dezash123/drone/README.md

# drone
My drone: coded in rust, frame designed in [onshape](https://cad.onshape.com/documents/91c1fbb6d04f2dc72182ab9c/w/1d5775c73044c5da3d093724/e/ebeab2adf1bd9151a745482d), and PCB designed in KiCAD.

much of this was learned through trial and error, and looking back, kinda embarrassing, but I'll keep this around since it did work
