dezash123/drone/pcb/Drone_PCB.kicad_pcb

## KiCad design pcb/Drone_PCB.kicad_pcb (2023-07-20)

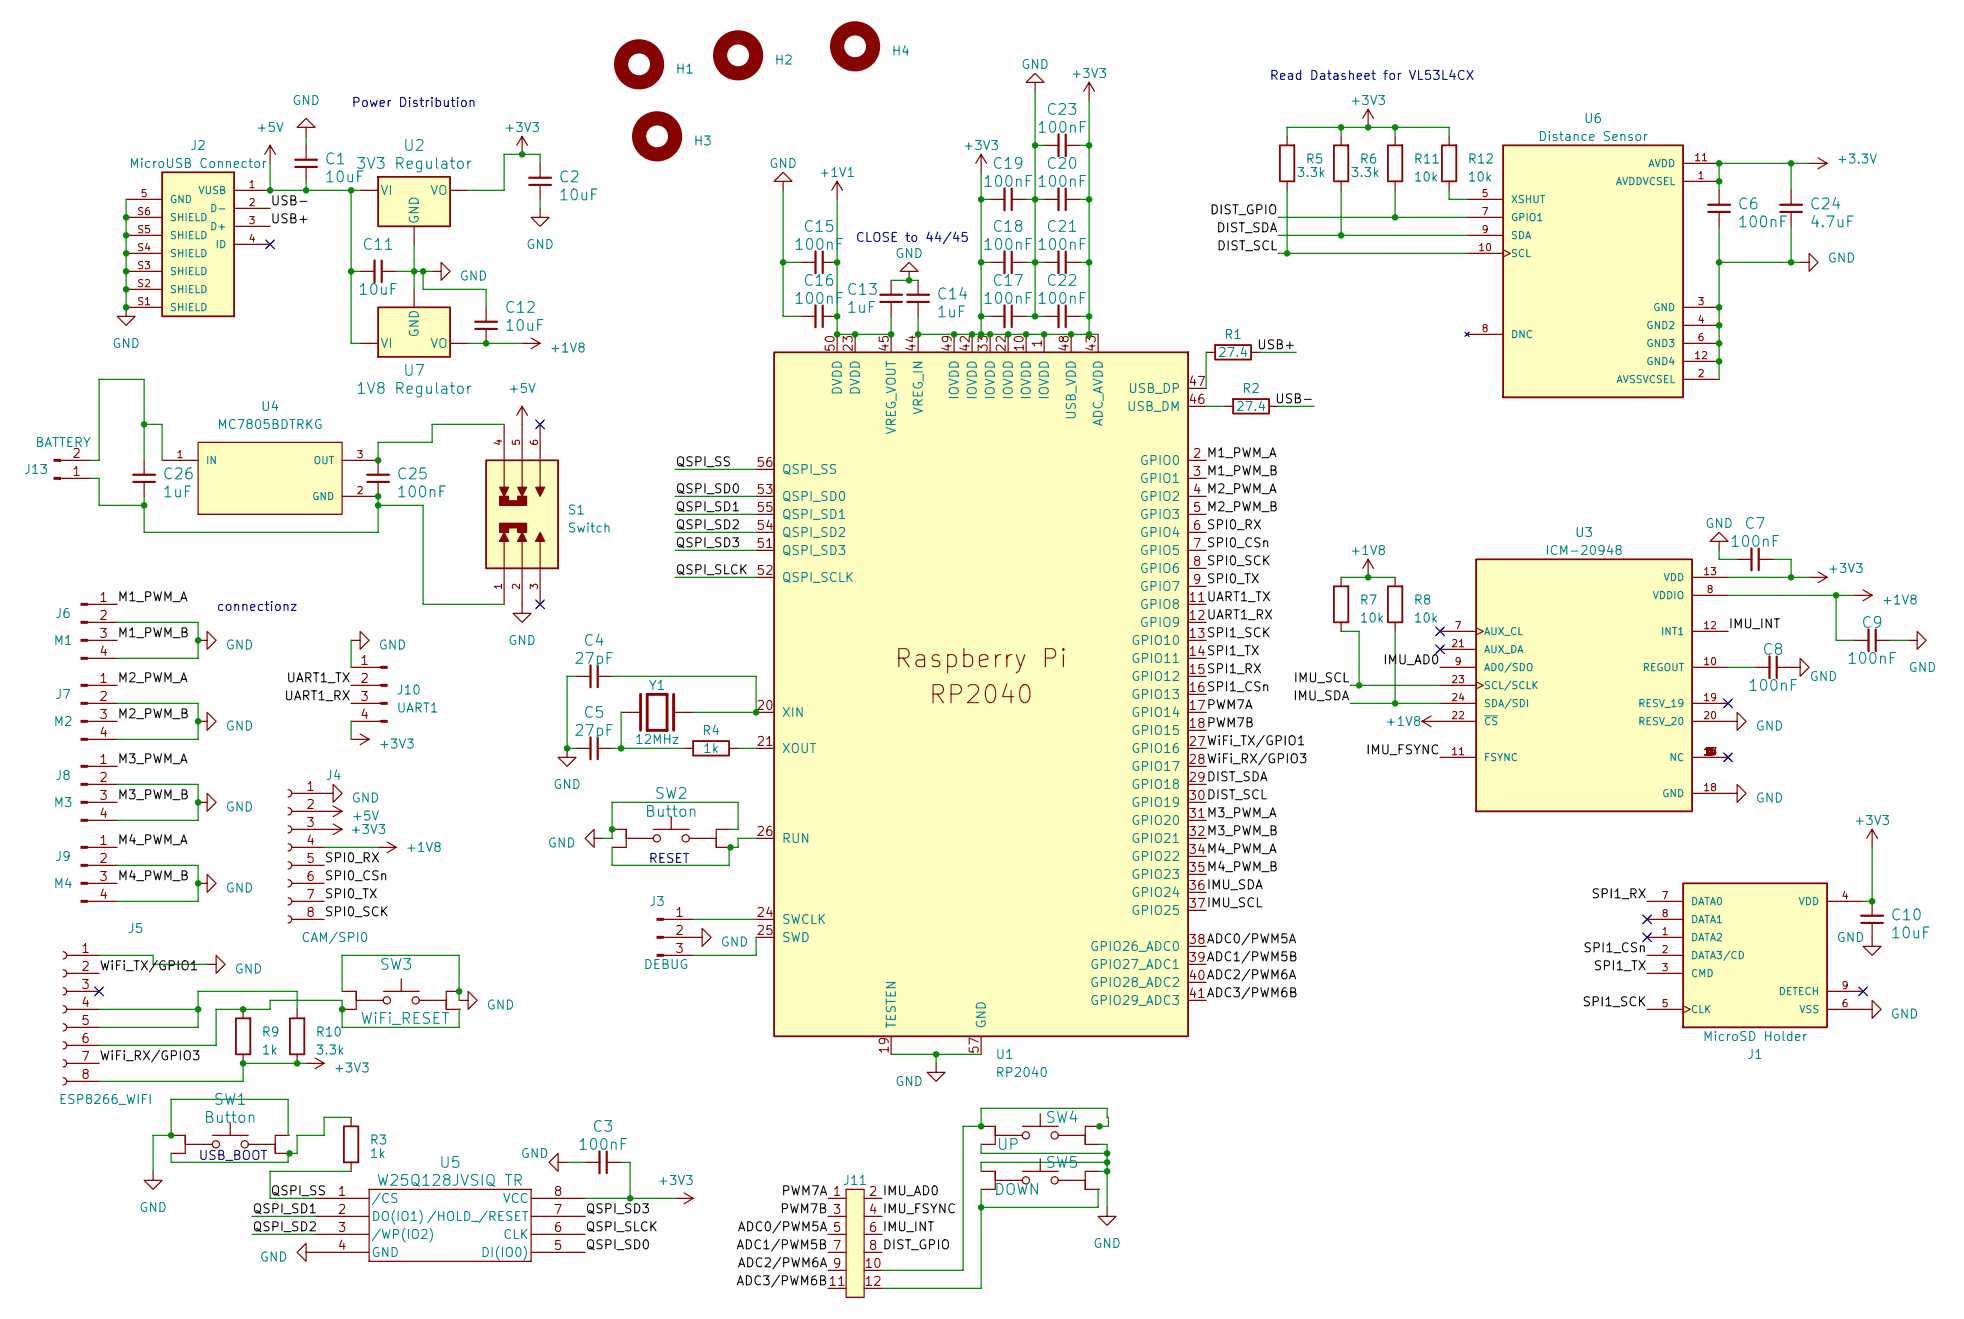
[picture p1: schematic Drone_PCB.kicad_sch]

Parts:
C1, C2, C10, C11, C12: 10uF; CAP_CL21_SAM
C3, C6, C7, C8, C9, C15, C16, C17, C18, C19, C20, C21, C22, C23, C25: 100nF; CAPC1005X56N
C4, C5: 27pF; CAPC1005X55N
C13, C14, C26: 1uF; CAPC1608X90N
C24: 4.7uF; CAPC1005X60N
H1, H2, H3, H4: MountingHole_2.2mm_M2
J1: MicroSD Holder; GCT_MEM2051-00-195-00-A
J2: MicroUSB Connector; AMPHENOL_10118193-0001LF; PARTREV E
J3: DEBUG; PinHeader_1x03_P2.54mm_Vertical
J4: CAM/SPI0; PinSocket_2x04_P2.54mm_Vertical
J5: ESP8266_WIFI; PinSocket_2x04_P2.54mm_Vertical
J6: M1; PinHeader_1x04_P2.54mm_Vertical
J7: M2; PinHeader_1x04_P2.54mm_Vertical
J8: M3; PinHeader_1x04_P2.54mm_Vertical
J9: M4; PinHeader_1x04_P2.54mm_Vertical
J10: UART1; PinHeader_1x04_P2.54mm_Vertical
J11: PinSocket_2x06_P2.54mm_Vertical
J13: BATTERY; AMASS_XT60-M_1x02_P7.20mm_Vertical
R1, R2: 27.4; RESC1005X35N
R3, R4, R9: 1k; RESC1005X40
R5, R6, R10: 3.3k; RESC1005X40
R7, R8, R11, R12: 10k; RESC1005X40N
S1: Switch; SW_EG2208; PARTREV C
SW1, SW2: Button; PTS 647 SN50 SMTR2 LFS
SW3: WiFi_RESET; PTS 647 SN50 SMTR2 LFS
SW4: UP; PTS 647 SN50 SMTR2 LFS
SW5: DOWN; PTS 647 SN50 SMTR2 LFS
U1: RP2040; RP2040-QFN-56
U2: 3V3 Regulator; SOT230P700X185-4N
U3: ICM-20948; QFN40P300X300X105-24N; PARTREV 1.3
U4: MC7805BDTRKG; DPAK229P990X238-4N; PARTREV 27
U5: W25Q128JVSIQ TR; SOIC_208MIL_WIN
U6: Distance Sensor; XCDR_VL53L4CXV0DH_1; PARTREV 4
U7: 1V8 Regulator; SOT223-3_ONS
Y1: 12MHz; XTAL_ABLS-12.000MHZ-K2-T; PARTREV 02.16.2021

Connections:
+1V1: C13.1, C15.1, C16.1, U1.23 (DVDD), U1.45 (VREG_VOUT), U1.50 (DVDD)
+1V8: C9.2, C12.1, J4.4, R7.2, R8.2, U3.8 (VDDIO), U3.22 (~CS), U7.2 (VO)
+5V: C1.1, C11.2, J2.1 (VUSB), J4.2, S1.5, U2.3 (VI), U7.3 (VI)
/ADC0/PWM5A: J11.5, U1.38 (GPIO26_ADC0)
/ADC1/PWM5B: J11.7, U1.39 (GPIO27_ADC1)
/ADC2/PWM6A: J11.9, U1.40 (GPIO28_ADC2)
/ADC3/PWM6B: J11.11, U1.41 (GPIO29_ADC3)
/DIST_GPIO: J11.8, R11.1, U6.7 (GPIO1)
/DIST_SCL: R5.1, U1.30 (GPIO19), U6.10 (SCL)
/DIST_SDA: R6.1, U1.29 (GPIO18), U6.9 (SDA)
/IMU_AD0: J11.2, U3.9 (AD0/SDO)
/IMU_FSYNC: J11.4, U3.11 (FSYNC)
/IMU_INT: J11.6, U3.12 (INT1)
/IMU_SCL: R7.1, U1.37 (GPIO25), U3.23 (SCL/SCLK)
/IMU_SDA: R8.1, U1.36 (GPIO24), U3.24 (SDA/SDI)
/M1_PWM_A: J6.1, U1.2 (GPIO0)
/M1_PWM_B: J6.3, U1.3 (GPIO1)
/M2_PWM_A: J7.1, U1.4 (GPIO2)
/M2_PWM_B: J7.3, U1.5 (GPIO3)
/M3_PWM_A: J8.1, U1.31 (GPIO20)
/M3_PWM_B: J8.3, U1.32 (GPIO21)
/M4_PWM_A: J9.1, U1.34 (GPIO22)
/M4_PWM_B: J9.3, U1.35 (GPIO23)
/PWM7A: J11.1, U1.17 (GPIO14)
/PWM7B: J11.3, U1.18 (GPIO15)
/QSPI_SD0: U1.53 (QSPI_SD0), U5.5 (DI(IO0))
/QSPI_SD1: U1.55 (QSPI_SD1), U5.2 (DO(IO1))
/QSPI_SD2: U1.54 (QSPI_SD2), U5.3 (/WP(IO2))
/QSPI_SD3: U1.51 (QSPI_SD3), U5.7 (/HOLD_/RESET)
/QSPI_SLCK: U1.52 (QSPI_SCLK), U5.6 (CLK)
/QSPI_SS: R3.2, U1.56 (QSPI_SS), U5.1 (/CS)
/SPI0_CSn: J4.6, U1.7 (GPIO5)
/SPI0_RX: J4.5, U1.6 (GPIO4)
/SPI0_SCK: J4.8, U1.8 (GPIO6)
/SPI0_TX: J4.7, U1.9 (GPIO7)
/SPI1_CSn: J1.2 (DATA3/CD), U1.16 (GPIO13)
/SPI1_RX: J1.7 (DATA0), U1.15 (GPIO12)
/SPI1_SCK: J1.5 (CLK), U1.13 (GPIO10)
/SPI1_TX: J1.3 (CMD), U1.14 (GPIO11)
/UART1_RX: J10.3, U1.12 (GPIO9)
/UART1_TX: J10.2, U1.11 (GPIO8)
/USB+: J2.3 (D+), R1.1
/USB-: J2.2 (D-), R2.1
/WiFi_RX/GPIO3: J5.7, U1.28 (GPIO17)
/WiFi_TX/GPIO1: J5.2, U1.27 (GPIO16)
GND: C1.2, C2.1, C3.2, C4.2, C5.2, C6.1, C7.2, C8.1, C9.1, C10.1, C11.1, C12.2, C13.2, C14.2, C15.2, C16.2, C17.1, C18.1, C19.1, C20.2, C21.2, C22.2, C23.2, C24.1, J1.6 (VSS), J2.5 (GND), J2.S1 (SHIELD), J2.S2 (SHIELD), J2.S3 (SHIELD), J2.S4 (SHIELD), J2.S5 (SHIELD), J2.S6 (SHIELD), J3.2, J4.1, J5.1, J6.2, J6.4, J7.2, J7.4, J8.2, J8.4, J9.2, J9.4, J10.1, S1.2, SW1.1, SW1.2, SW2.1, SW2.2, SW3.1, SW3.2, SW4.3, SW4.4, SW5.1, SW5.2, U1.19 (TESTEN), U1.57 (GND), U2.1 (GND), U3.18 (GND), U3.20 (RESV_20), U5.4 (GND), U6.2 (AVSSVCSEL), U6.3 (GND), U6.4 (GND2), U6.6 (GND3), U6.12 (GND4), U7.1 (GND)
unnamed: C5.1, R4.2, Y1.1
unnamed: J3.1, U1.24 (SWCLK)
unnamed: J3.3, U1.25 (SWD)
unnamed: J5.4, J5.5, R10.2
unnamed: J5.6, R9.2, SW3.3, SW3.4
unnamed: J11.10, SW4.1, SW4.2
unnamed: J11.12, SW5.3, SW5.4
unnamed: C25.1, C26.1, J13.1, S1.1, U4.2 (GND)
unnamed: C26.2, J13.2, U4.1 (IN)
unnamed: R3.1, SW1.3, SW1.4
unnamed: SW2.3, SW2.4, U1.26 (RUN)
unnamed: R2.2, U1.46 (USB_DM)
unnamed: R1.2, U1.47 (USB_DP)
unnamed: C4.1, U1.20 (XIN), Y1.2
unnamed: R4.1, U1.21 (XOUT)
unnamed: C8.2, U3.10 (REGOUT)
unnamed: C25.2, S1.4, U4.3 (OUT)
unnamed: R12.1, U6.5 (XSHUT)

Notes on the sheet:
Power Distribution
Read Datasheet for VL53L4CX
RESET
USB_BOOT
connectionz
CLOSE to 44/45

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
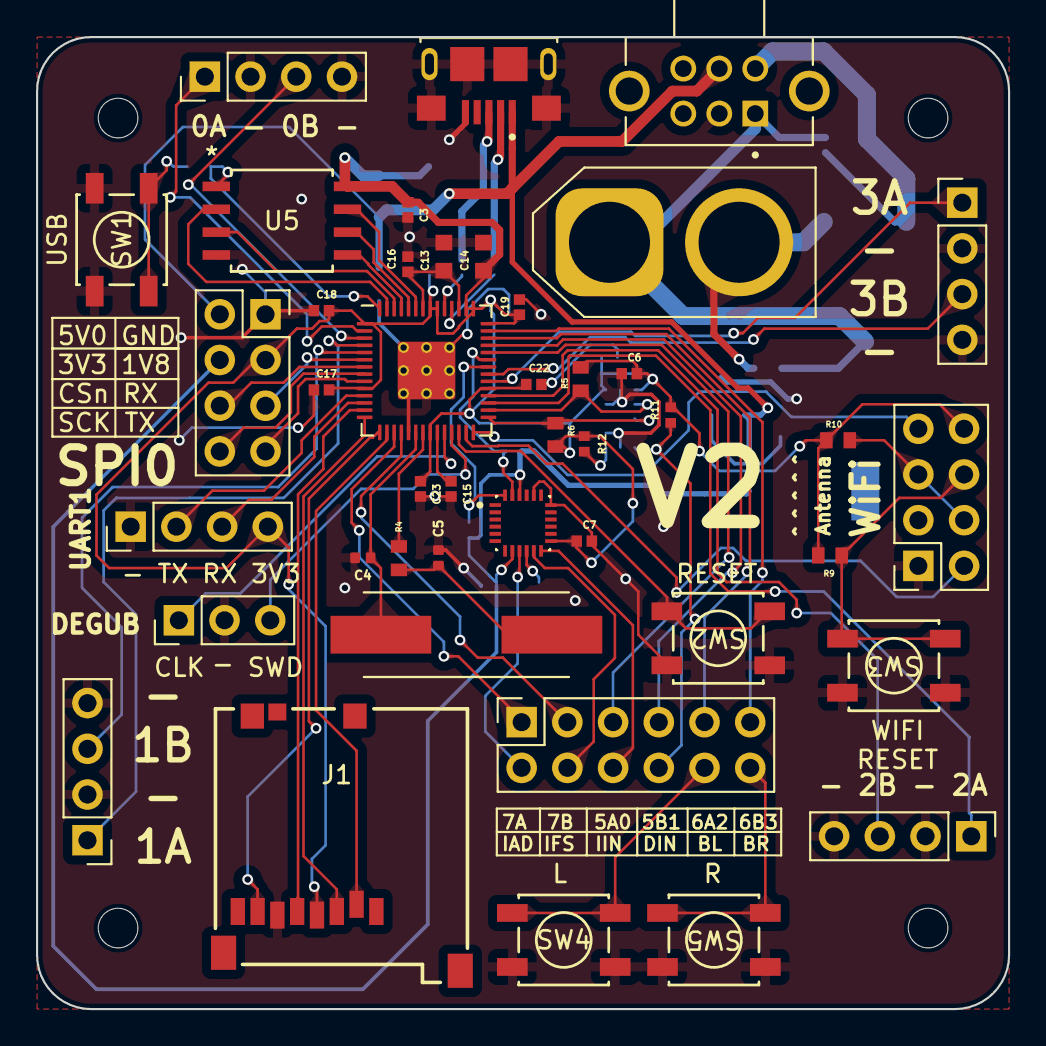
[picture p2: board Drone_PCB.kicad_pcb from above]

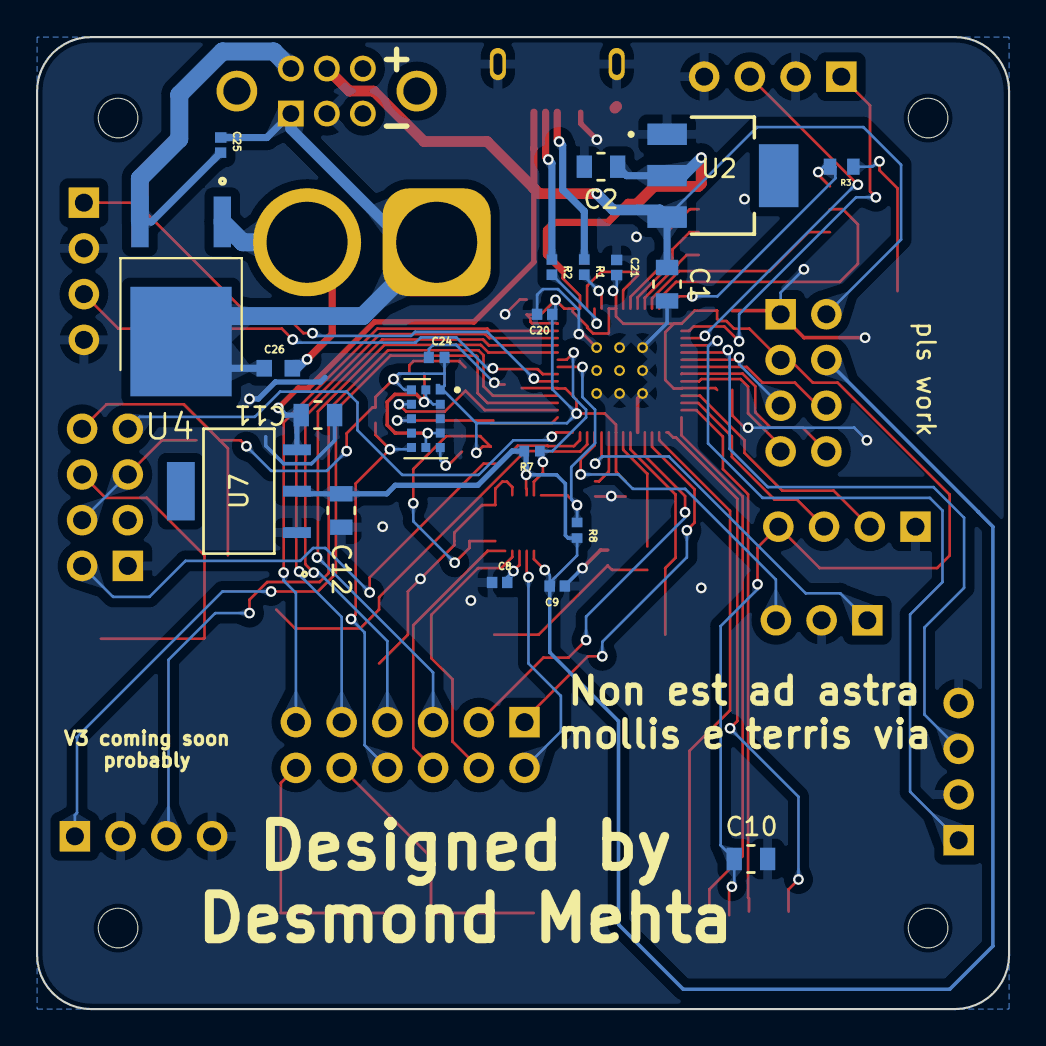
[picture p3: board Drone_PCB.kicad_pcb from below]

Board: 2 copper layers, 54.0 x 54.0 mm, 68 parts (21 on the bottom side), 65 nets.
