dezash123/drone/(commit log)

2023-05-12 PCB CAD git add .git add .
    [10118193-0001LF.step, C0402C270F5GAC.step, DA14531MOD-00F01002.step, Drone_PCB.kicad_pcb, Drone_PCB.kicad_sch, ICM-20948.step, JS1400AFQ.step, MEM2051-00-195-00-A.step]
2023-05-20 doin stuff
    [10118193-0001LF.step, C0402C270F5GAC.step, DA14531MOD-00F01002.step, Drone_PCB.kicad_pcb, Drone_PCB.kicad_sch, ICM-20948.step, JS1400AFQ.step, MEM2051-00-195-00-A.step]
2023-05-22 finished pcb
    [Drone_PCB-B_Cu.gbr, Drone_PCB-B_Mask.gbr, Drone_PCB-B_Paste.gbr, Drone_PCB-B_Silkscreen.gbr, Drone_PCB-Edge_Cuts.gbr, Drone_PCB-F_Cu.gbr, Drone_PCB-F_Mask.gbr, Drone_PCB-F_Paste.gbr]
2023-05-24 pcb actually done
    [Drone_PCB-B_Cu.gbr, Drone_PCB-B_Mask.gbr, Drone_PCB-B_Paste.gbr, Drone_PCB-B_Silkscreen.gbr, Drone_PCB-Edge_Cuts.gbr, Drone_PCB-F_Cu.gbr, Drone_PCB-F_Mask.gbr, Drone_PCB-F_Paste.gbr]
2023-06-16 pcb V2
    [200mm Toroidal .step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]
2023-06-17 finished PCB V2
    [Drone_PCB.csv, Drone_PCB.kicad_pcb, Drone_PCB.kicad_sch]
2023-07-08 wrote most of IMU driver
    [70mm Toroidal Propellor CCW.step, 70mm Toroidal Propellor CW.step, Drone_PCB.kicad_pcb, Toroidal V2 - Propellor.step, V3 (Mini) - Drone.step, V3 (Mini) - Top.step]
2023-07-08 wrote most of IMU drive
2023-07-09 saving nice errors but might have to remove
    [imu.rs, main.rs]
2023-07-27 many stuff
    [PCBV2 Case - Drone Body.step]
2023-07-27 NO MORE DRIVERS
2023-07-29 reorganized and removed unnecessary STEP files
    [200mm Toroidal .step, 50mm Toroidal Propellor.step, 60mm Toroidal - Propellor.step, 70mm Toroidal Propellor CCW.step, 70mm Toroidal Propellor CW.step, Base.step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]
2023-09-19 MPC Kalman filters AAAA
2023-11-09 redoing imu for millionth time and adding magnetometer readings for absolute angle
